ryanguo13/XTEINK_X4_Case/docs/images/06_back_shell_outside.png

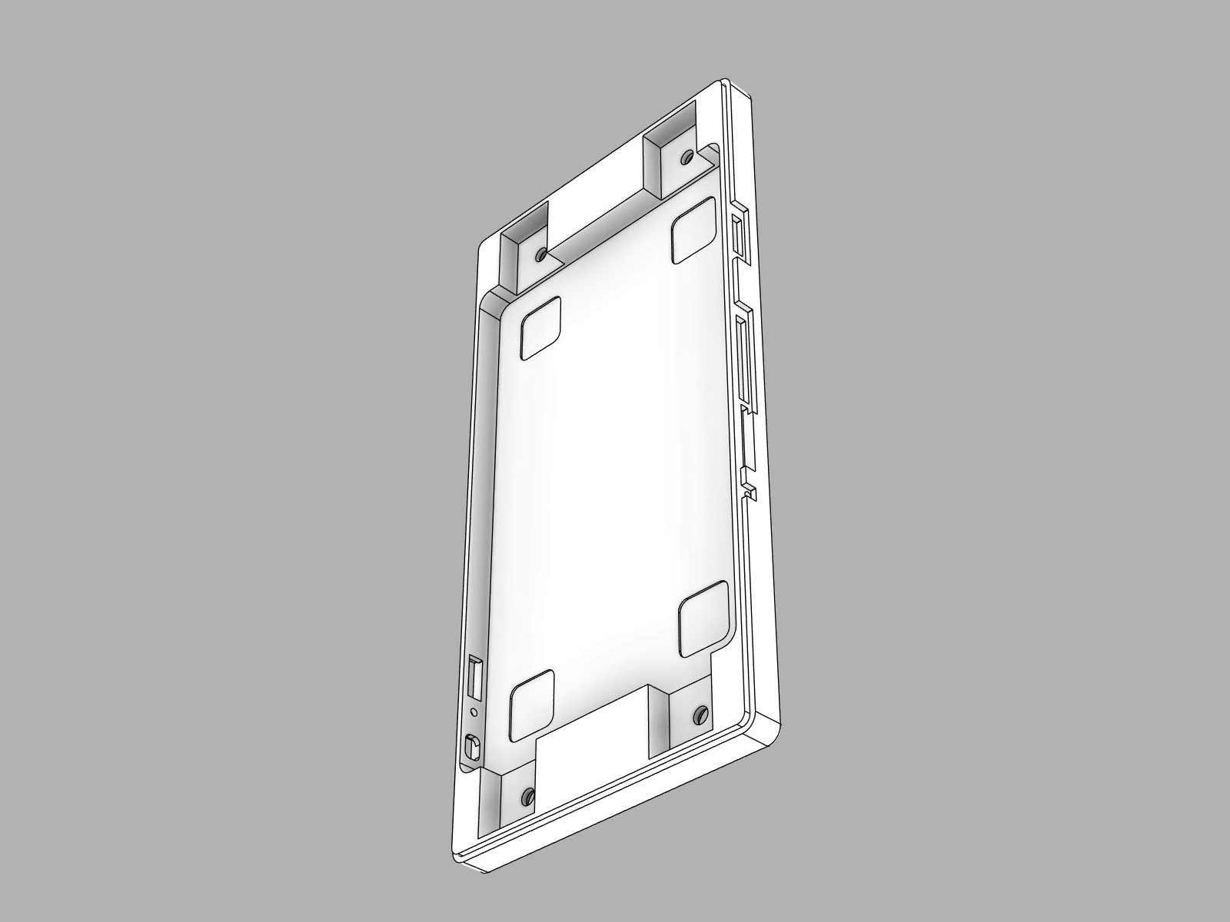
docs/images/06_back_shell_outside.png
