ryanguo13/XTEINK_X4_Case/docs/images/07_front_frame_outside.png

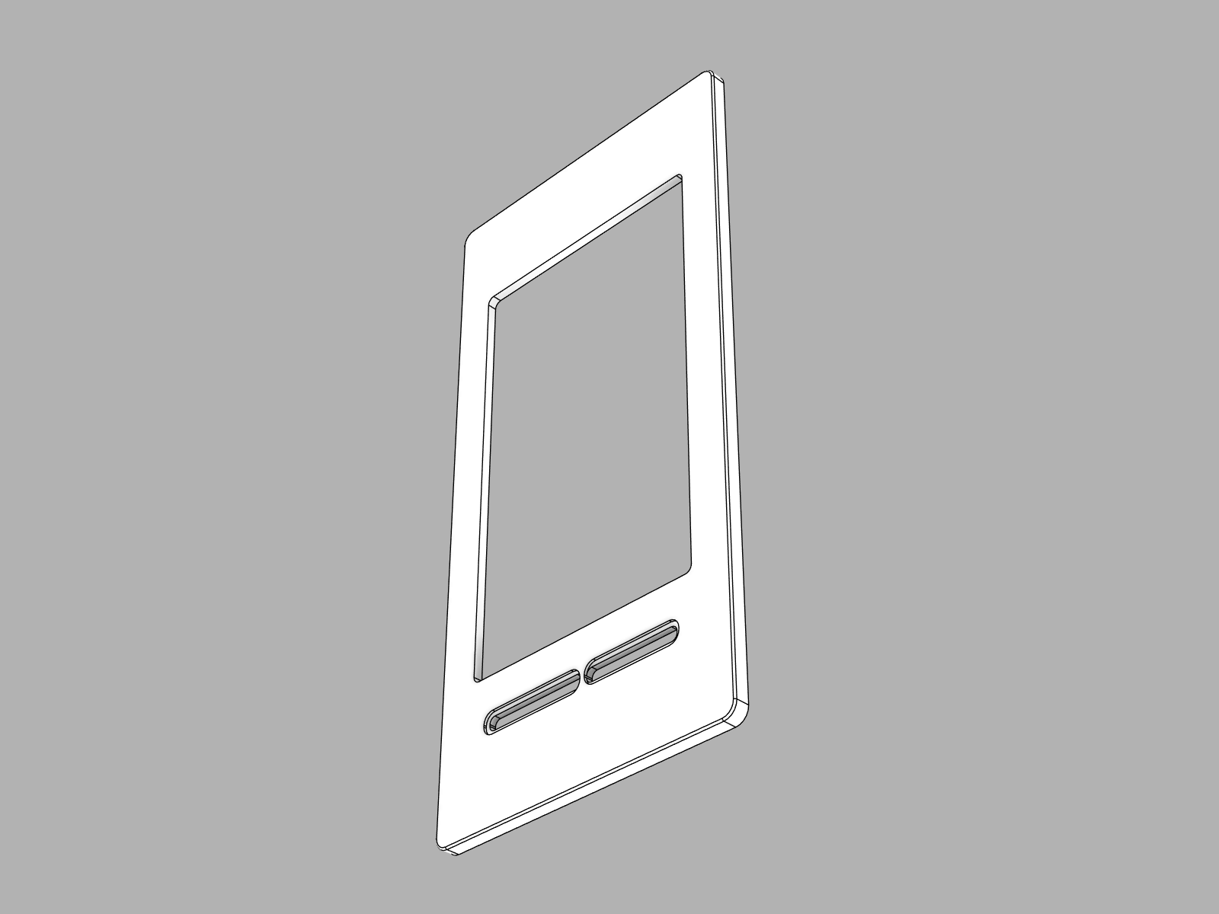
docs/images/07_front_frame_outside.png
