ryanguo13/XTEINK_X4_Case/docs/images/08_front_frame_inside.png

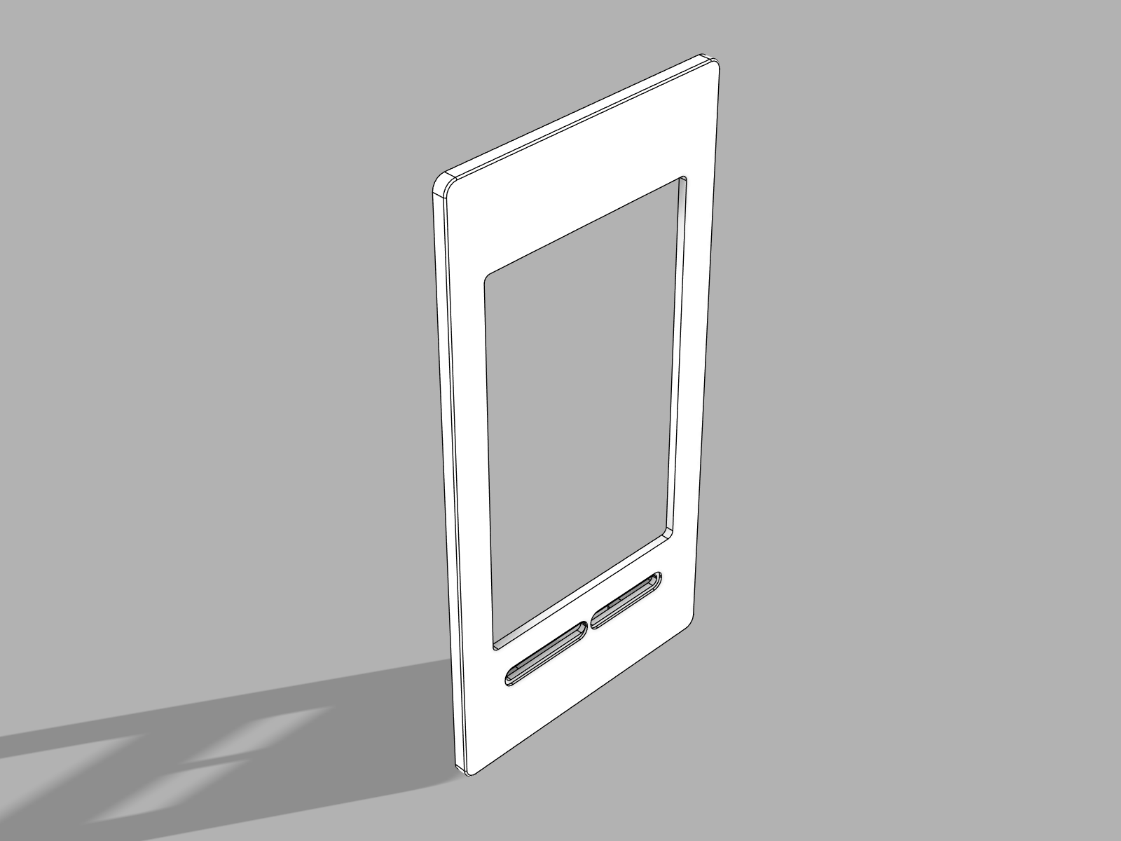
docs/images/08_front_frame_inside.png
