ryanguo13/XTEINK_X4_Case/docs/images/09_side_ports.png

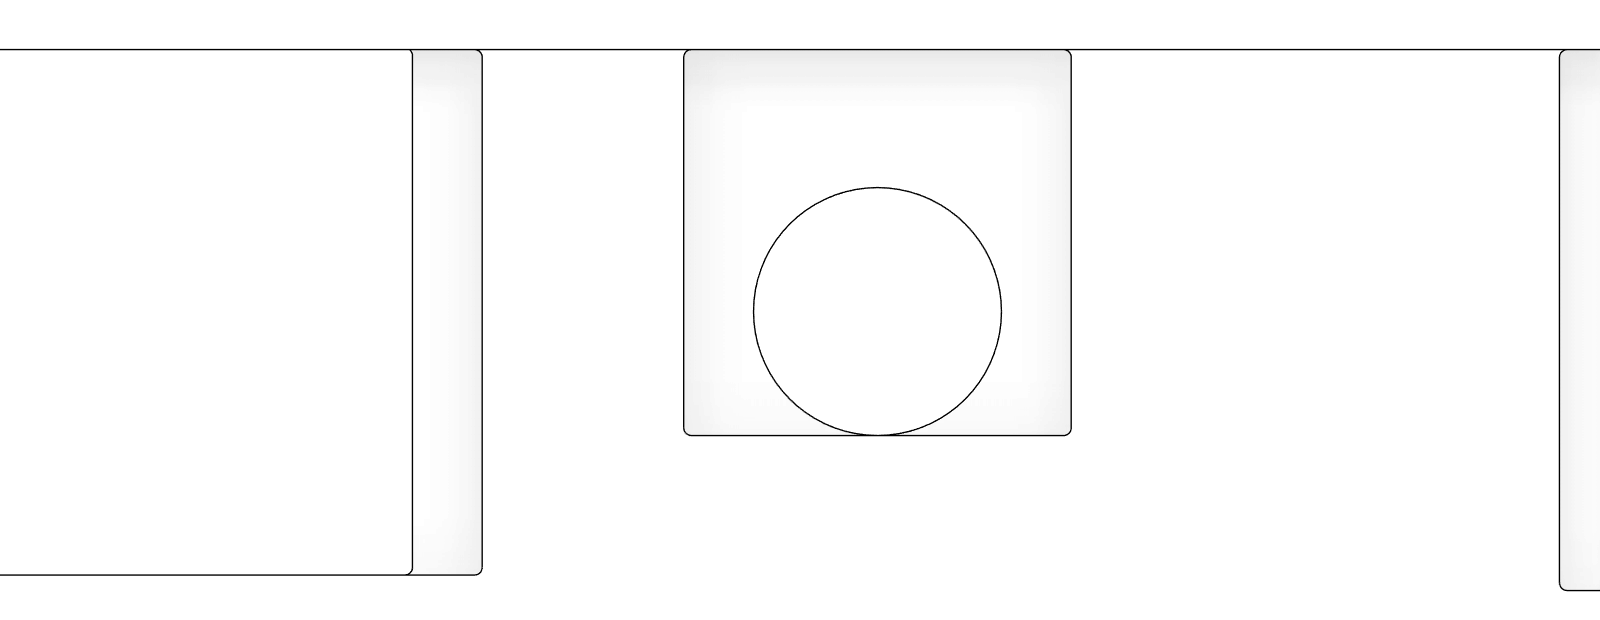
docs/images/09_side_ports.png
