ryanguo13/XTEINK_X4_Case/docs/images/10_side_keys.png

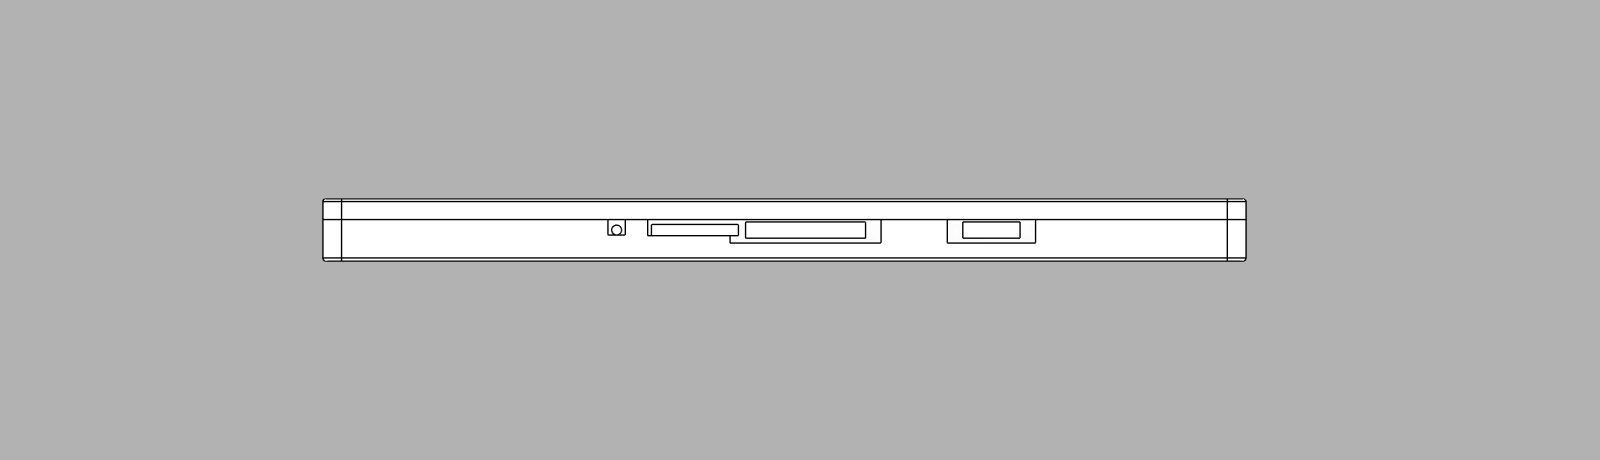
docs/images/10_side_keys.png
