ryanguo13/XTEINK_X4_Case/docs/images/12_exploded_back.png

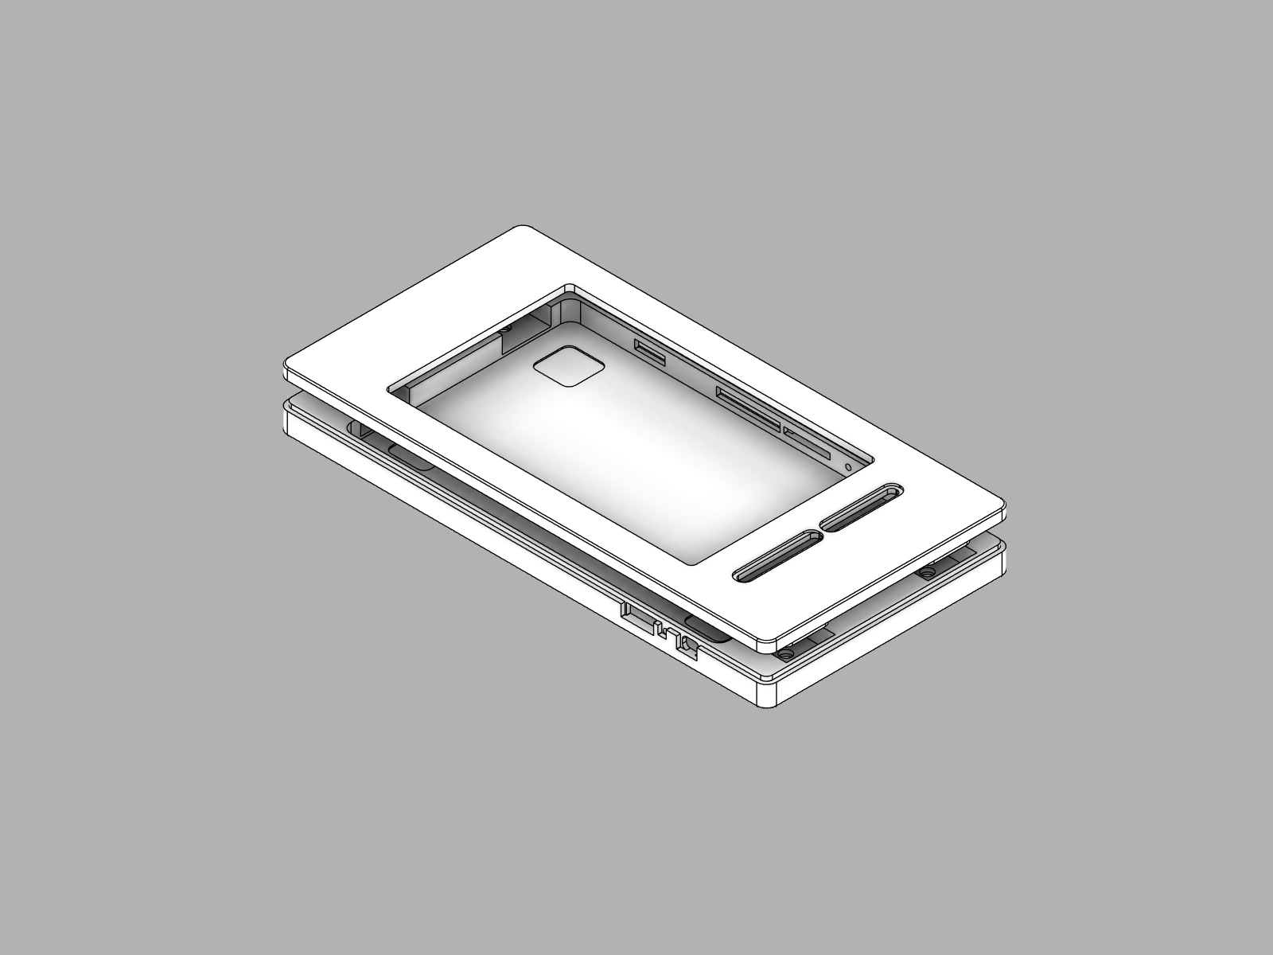
docs/images/12_exploded_back.png
