ryanguo13/XTEINK_X4_Case/ref/2025110509382118.jpg

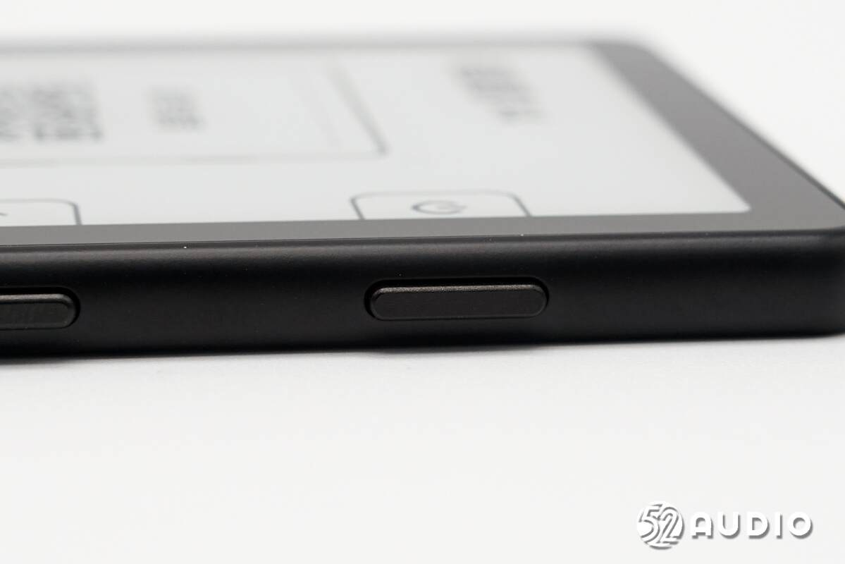
ref/2025110509382118.jpg
