ryanguo13/XTEINK_X4_Case/ref/2025110509383175.jpg

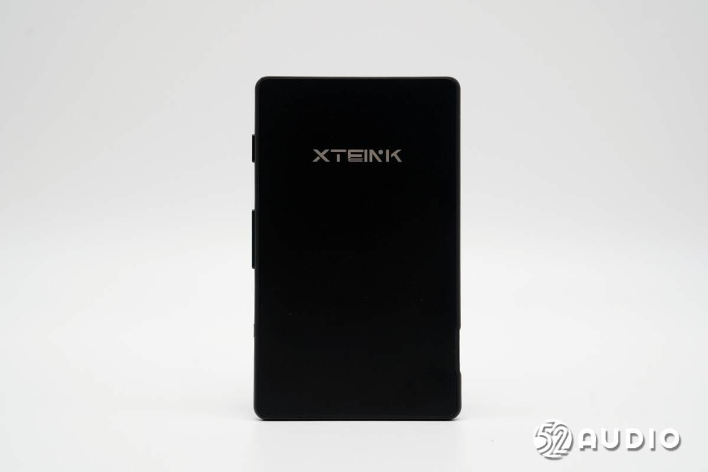
ref/2025110509383175.jpg
