ryanguo13/XTEINK_X4_Case/ref/2025110509383191.jpg

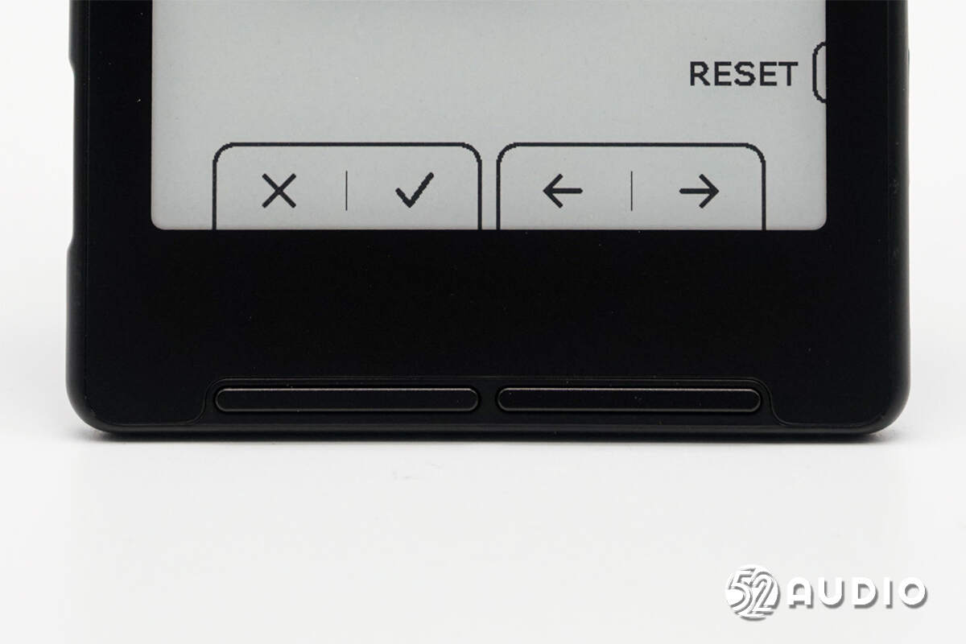
ref/2025110509383191.jpg
