ryanguo13/XTEINK_X4_Case/ref/front.jpg

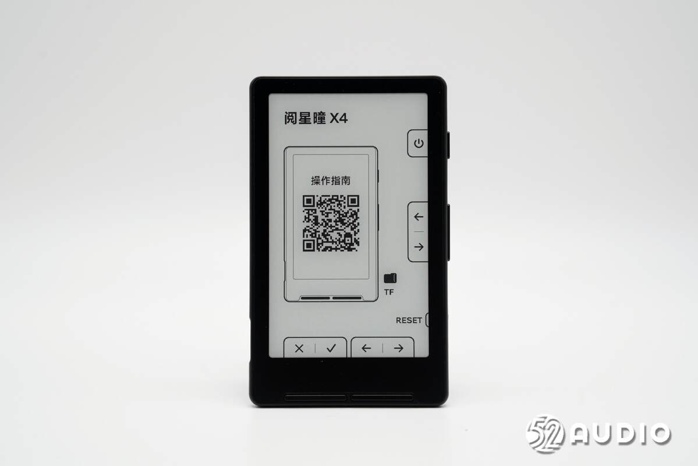
ref/front.jpg
