ryanguo13/XTEINK_X4_Case/ref/Screenshot 2026-10-22 153344.png

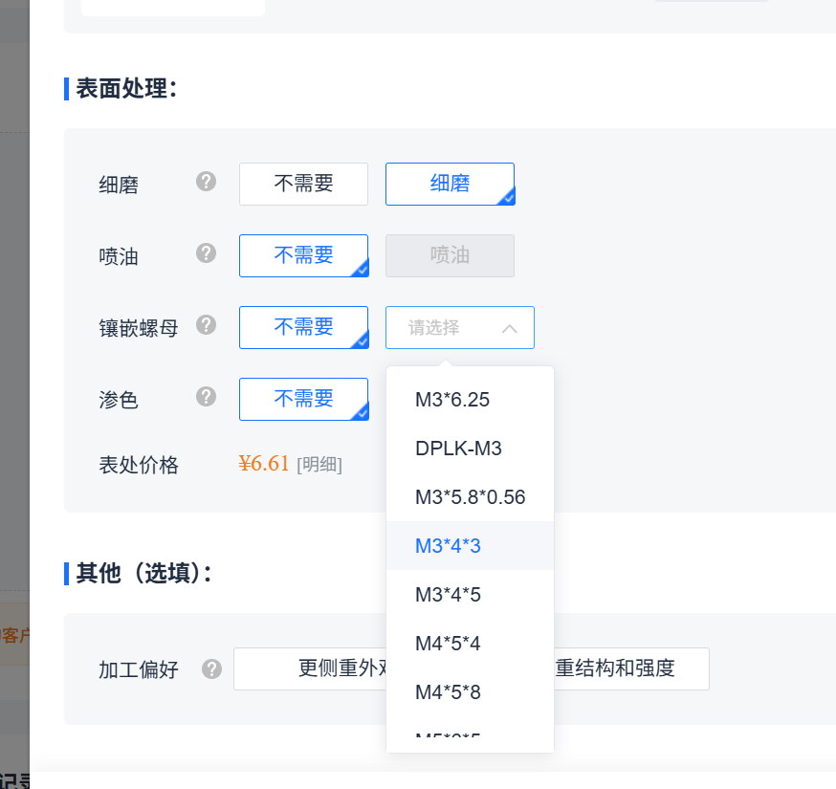
ref/Screenshot 2026-10-22 153344.png
