ryanguo13/XTEINK_X4_Case/ref/tmp/c3025.png

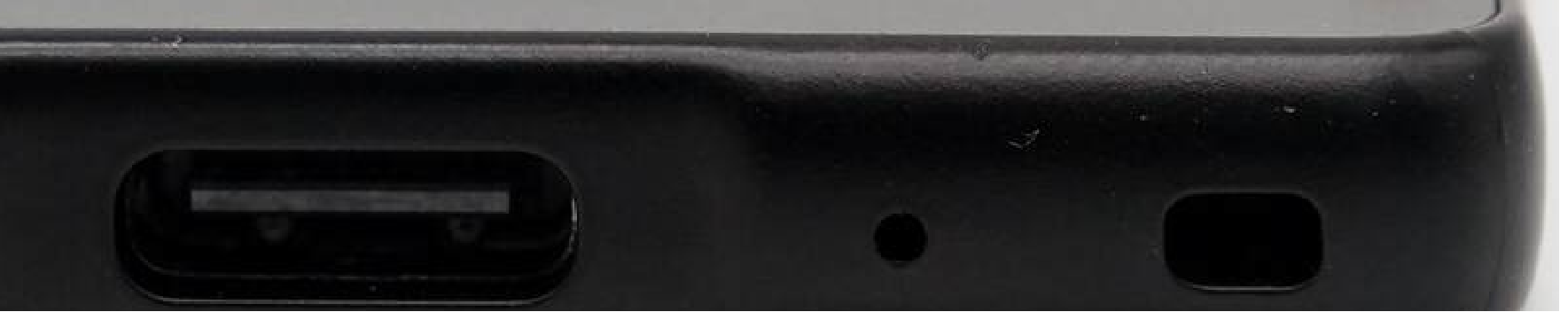
ref/tmp/c3025.png
