ryanguo13/XTEINK_X4_Case/ref/tmp/c3469b.png

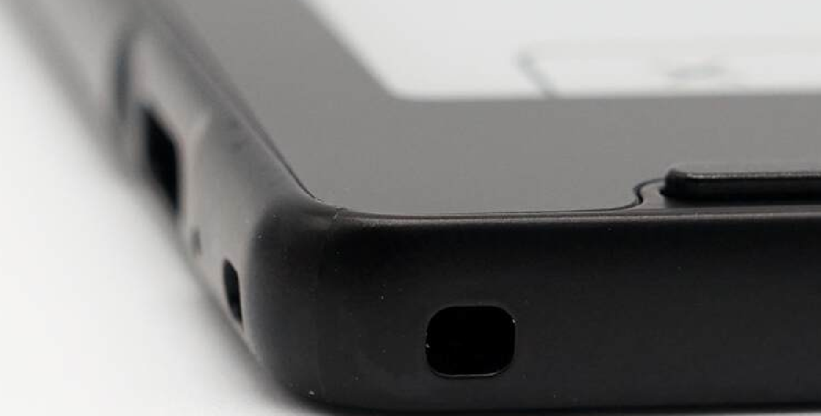
ref/tmp/c3469b.png
