ryanguo13/XTEINK_X4_Case/ref/tmp/e3389.png

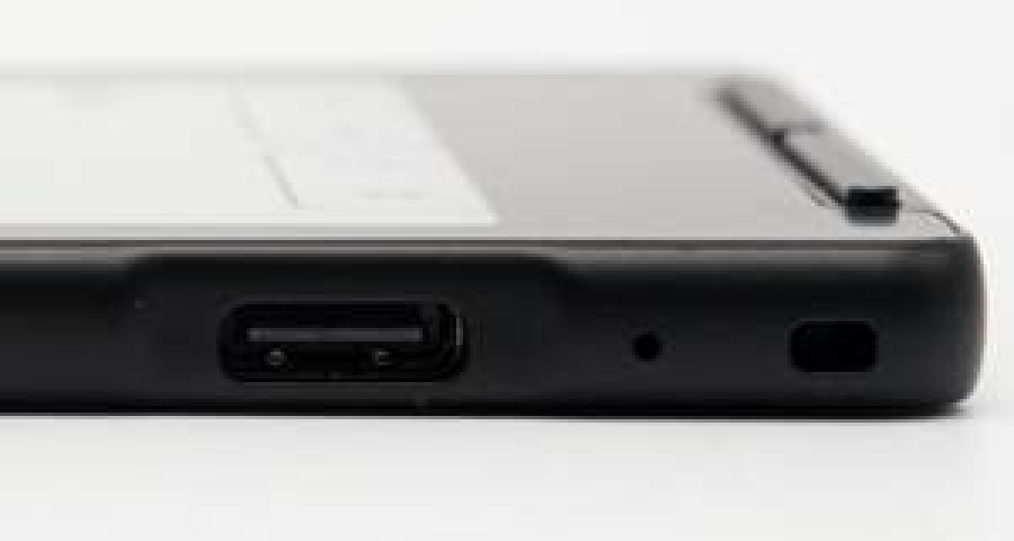
ref/tmp/e3389.png
