ryanguo13/XTEINK_X4_Case/stl/X4_back_shell.stl

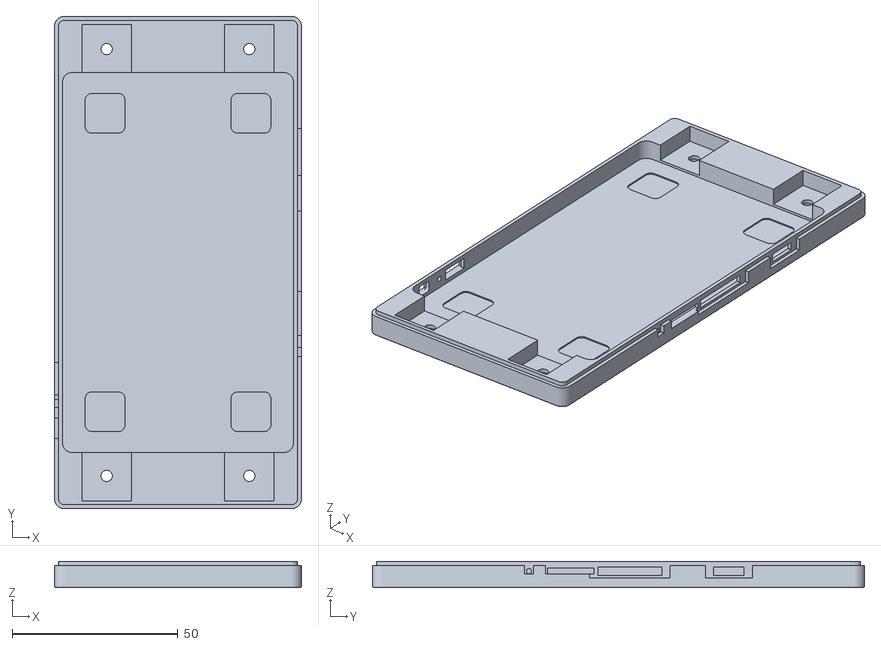
[picture p27: CAD file, 2026-10-23]
stl/X4_back_shell.stl
74.5 x 148.5 x 7.98
