ryanguo13/XTEINK_X4_Case/stl/X4_front_frame.stl

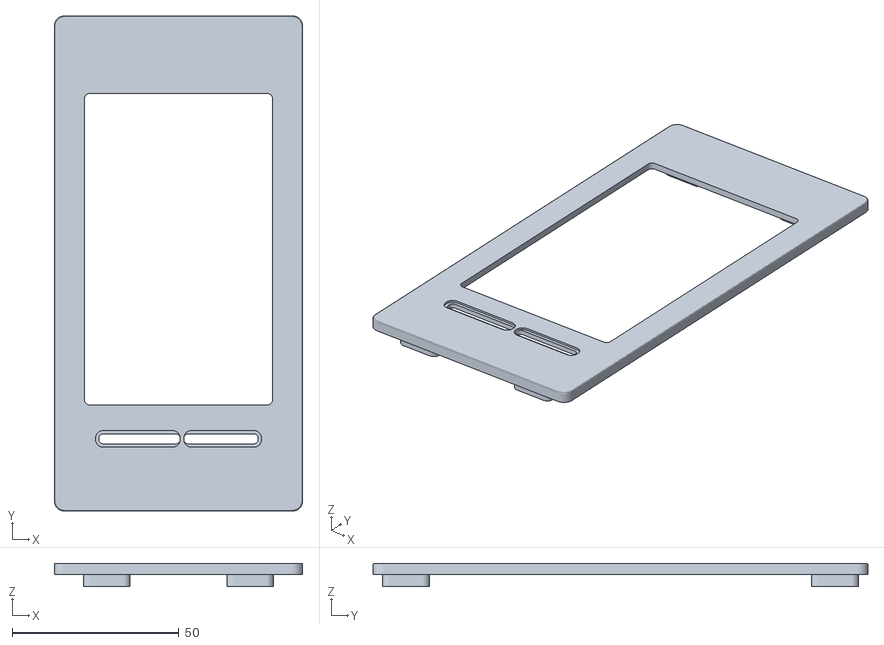
[picture p28: CAD file, 2026-10-23]
stl/X4_front_frame.stl
74.5 x 148.5 x 6.98
