ryanguo13/XTEINK_X4_Case/(commit log)

2026-10-21 X4 外壳：方正工业风两件套 + 技术文档 + 生产指南
    建模
    - x4_case_fusion.py 全参数化 Fusion 360 脚本，一键重建 + 干涉检查 + 导出 STL
    - 两件套：全包背壳 (73.30 x 118.30 x 7.98) + 前框 (73.30 x 118.30 x 2.40)
    - 外形平面圆角 R6.8 -> R3.0 方正化；角部壁厚 1.80 -> 2.13, 角部设备间隙 0.08 -> 0.56
    - 按钮全部镂空让位（+X 侧 4 孔 / -X 侧 3 孔 / 正面两条胶囊键）
    - 背面装饰面板内凹 + phi60 磁吸环让位槽 + 4 个缓冲垫沉台
    - 卡接径向过盈 0.10 mm，装配重叠 1.20 mm
    修复
    - extrude() 增加 target 参数：CutFeatureOperation 作用域是整个设计，
    未限定 participantBodies 时前框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
    [X4_back_shell.stl, X4_front_frame.stl]
2026-10-21 加 .gitattributes：二进制资源不做行尾转换
2026-10-21 删除 run_x4.py：与 dev_run.py 完全重复
    dev_run.py 是它的超集（带 &quot;空 proxy handler&quot; 修复，能跑任意脚本路径）,
    run_x4.py 硬编码了 x4_case_fusion.py 且被代理拦成 502。
2026-10-22 改为 4×M3 螺钉固定：上下加长容纳热熔螺母
    放弃 0.10 mm 径向过盈卡接（FDM 公差不可控，拆装十几次即松），
    改用背壳 4 个沉头孔 + 前框 4 个 Ø5.6 螺母柱内嵌嘉立创 M3*4*3 热熔螺母。
    - 上下加长 ext_top 8.0 / ext_bot 10.0（设备顶/底边到外形边 2.15 → 10.15/12.15），
    只加壁区，内腔仍 69.70 × 114.70；外形变为 73.30 × 136.30，Y 不再对称，
    引入 s_y0/s_y1/s_cy 与 ring2_prof() 处理非同心轮廓
    - 定位筋保留但改为纯定位：ridge_clear 0.02，groove_d = ridge_p − skirt_gap
    + ridge_clear = 0.27（原公式符号写反导致整合圈 0.02 mm 干涉）
    - 螺钉：沉孔 Ø6.2×1.8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
    [X4_back_shell.stl, X4_front_frame.stl]
2026-10-22 改为嘉立创代嵌合规版：Ø12×10 扁平螺母凸台 + M3*4*3 代嵌加工图纸
    - 4 个 Ø5.6 圆螺母柱 → 12×10 R2 扁平凸台，孔周壁厚 X 4.05 / Y 3.05（≥ 嘉立创 3 mm 要求）
    - 底孔 Ø3.8×4.2 → Ø3.9×4.0（对齐嘉立创 M3*4*3 官方口径），孔底壁 1.28
    - 背壳让位腔同步改矩形 12.6×10.8 R2.3（凸台 + 单边 0.30 让位间隙）
    - 总高 136.30 → 139.30（ext_top = ext_bot = 10.50，恢复 Y 对称 s_cy = 0）
    - panel_h 120 → 116（避开沉孔、保持面板边距）
    - 重建验证：背壳 26.30 cm³ / 前框 8.65 cm³，三项干涉 0；12 张文档图与 STL 同步重出
    - 新增 docs/X4_nut_drawing.pdf（A3 横向 4 页）：布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
    [X4_back_shell.stl, X4_front_frame.stl]
2026-10-23 按嘉立创代嵌要求重做：14×14 螺母凸台 + 侧壁 2.4 + 消除全部 <1mm 薄壁
    上一版 12×10 扁平凸台被嘉立创判为不合规（安装面应 ≥14×14 平面），
    且 0.35 定位筋环槽把前口环壁切到 0.73、槽底圆角相切处收敛到 0.1 mm，
    触发"最小壁厚不足"退回。
    结构变更
    - 螺母凸台 12×10 R2 → 14×14 R2 平面，Z 1.90…6.90 → 1.00…7.98（与面板外面齐平）
    - 底孔 Ø3.9×4.0 → Ø3.6×5.0（回到官方口径），孔顶 Z 6.00，顶壁 1.98，孔周壁 5.20
    - 让位腔 12.6×10.8 R2.3 → 15.4×14.2 直角（R2.4 圆弧会以极浅角切进内腔壁
    Y=±57.35，留下收敛到零的楔形料，实测 0.04/0.06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
    [X4_back_shell.stl, X4_front_frame.stl]
